xiaoyuehai/heichips26-e2spike/macros/heichips26_e2spike/macros/counter/netlist/spice/counter.spice

* NGSPICE file created from counter.ext - technology: ihp-sg13cmos5l

* Black-box entry subcircuit for sg13cmos5l_decap_8 abstract view
.subckt sg13cmos5l_decap_8 VDD VSS
.ends

* Black-box entry subcircuit for sg13cmos5l_decap_4 abstract view
.subckt sg13cmos5l_decap_4 VDD VSS
.ends

* Black-box entry subcircuit for sg13cmos5l_nor3_2 abstract view
.subckt sg13cmos5l_nor3_2 Y A B C VDD VSS
.ends

* Black-box entry subcircuit for sg13cmos5l_xor2_1 abstract view
.subckt sg13cmos5l_xor2_1 X A B VDD VSS
.ends

* Black-box entry subcircuit for sg13cmos5l_fill_2 abstract view
.subckt sg13cmos5l_fill_2 VDD VSS
.ends

* Black-box entry subcircuit for sg13cmos5l_dlygate4sd3_1 abstract view
.subckt sg13cmos5l_dlygate4sd3_1 X A VDD VSS
.ends

* Black-box entry subcircuit for sg13cmos5l_buf_1 abstract view
.subckt sg13cmos5l_buf_1 X A VDD VSS
.ends

* Black-box entry subcircuit for sg13cmos5l_tiehi abstract view
.subckt sg13cmos5l_tiehi L_HI VDD VSS
.ends

* Black-box entry subcircuit for sg13cmos5l_fill_1 abstract view
.subckt sg13cmos5l_fill_1 VDD VSS
.ends

* Black-box entry subcircuit for sg13cmos5l_inv_1 abstract view
.subckt sg13cmos5l_inv_1 Y A VDD VSS
.ends

* Black-box entry subcircuit for sg13cmos5l_nand4_1 abstract view
.subckt sg13cmos5l_nand4_1 Y A B C D VDD VSS
.ends

* Black-box entry subcircuit for sg13cmos5l_nor2b_1 abstract view
.subckt sg13cmos5l_nor2b_1 Y A B_N VDD VSS
.ends

* Black-box entry subcircuit for sg13cmos5l_nor2_1 abstract view
.subckt sg13cmos5l_nor2_1 Y A B VDD VSS
.ends

* Black-box entry subcircuit for sg13cmos5l_and2_1 abstract view
.subckt sg13cmos5l_and2_1 X A B VDD VSS
.ends

* Black-box entry subcircuit for sg13cmos5l_a21oi_1 abstract view
.subckt sg13cmos5l_a21oi_1 Y A1 A2 B1 VDD VSS
.ends

* Black-box entry subcircuit for sg13cmos5l_buf_4 abstract view
.subckt sg13cmos5l_buf_4 X A VDD VSS
.ends

* Black-box entry subcircuit for sg13cmos5l_or3_1 abstract view
.subckt sg13cmos5l_or3_1 X A B C VDD VSS
.ends

* Black-box entry subcircuit for sg13cmos5l_nand3_1 abstract view
.subckt sg13cmos5l_nand3_1 Y A B C VDD VSS
.ends

* Black-box entry subcircuit for sg13cmos5l_buf_8 abstract view
.subckt sg13cmos5l_buf_8 X A VDD VSS
.ends

* Black-box entry subcircuit for sg13cmos5l_o21ai_1 abstract view
.subckt sg13cmos5l_o21ai_1 Y A1 A2 B1 VDD VSS
.ends

* Black-box entry subcircuit for sg13cmos5l_nand2_1 abstract view
.subckt sg13cmos5l_nand2_1 Y A B VDD VSS
.ends

* Black-box entry subcircuit for sg13cmos5l_dfrbpq_1 abstract view
.subckt sg13cmos5l_dfrbpq_1 Q CLK D RESET_B VDD VSS
.ends

* Black-box entry subcircuit for sg13cmos5l_xnor2_1 abstract view
.subckt sg13cmos5l_xnor2_1 Y A B VDD VSS
.ends

* Black-box entry subcircuit for sg13cmos5l_mux2_1 abstract view
.subckt sg13cmos5l_mux2_1 X A0 A1 S VDD VSS
.ends

.subckt counter VGND VPWR clk_i count_o[0] count_o[1] count_o[2] count_o[3] count_o[4]
+ count_o[5] count_o[6] count_o[7] enable_i rst_ni
XFILLER_7_7 VPWR VGND sg13cmos5l_decap_8
XFILLER_3_67 VPWR VGND sg13cmos5l_decap_8
XFILLER_9_126 VPWR VGND sg13cmos5l_decap_8
XFILLER_13_144 VPWR VGND sg13cmos5l_decap_4
XFILLER_5_140 VPWR VGND sg13cmos5l_decap_8
X_66_ _67_/S _66_/A _66_/B _66_/C VPWR VGND sg13cmos5l_nor3_2
XFILLER_0_35 VPWR VGND sg13cmos5l_decap_8
XFILLER_9_77 VPWR VGND sg13cmos5l_decap_8
X_49_ _49_/X _59_/C _49_/B VPWR VGND sg13cmos5l_xor2_1
XFILLER_18_97 VPWR VGND sg13cmos5l_decap_8
XFILLER_18_42 VPWR VGND sg13cmos5l_fill_2
XFILLER_18_20 VPWR VGND sg13cmos5l_fill_2
Xhold30 _59_/C _71_/Q VPWR VGND sg13cmos5l_dlygate4sd3_1
XFILLER_6_56 VPWR VGND sg13cmos5l_decap_8
Xoutput7 count_o[4] _72_/Q VPWR VGND sg13cmos5l_buf_1
XFILLER_11_0 VPWR VGND sg13cmos5l_decap_8
X_75__14 _75__14/L_HI VPWR VGND sg13cmos5l_tiehi
XFILLER_3_46 VPWR VGND sg13cmos5l_decap_8
XFILLER_9_105 VPWR VGND sg13cmos5l_decap_8
XFILLER_9_149 VPWR VGND sg13cmos5l_fill_1
XFILLER_13_123 VPWR VGND sg13cmos5l_decap_8
XFILLER_6_119 VPWR VGND sg13cmos5l_decap_8
XFILLER_10_137 VPWR VGND sg13cmos5l_decap_8
XFILLER_10_148 VPWR VGND sg13cmos5l_fill_2
X_65_ _66_/A _65_/A VPWR VGND sg13cmos5l_inv_1
XFILLER_2_133 VPWR VGND sg13cmos5l_decap_8
XFILLER_0_14 VPWR VGND sg13cmos5l_decap_8
XFILLER_9_56 VPWR VGND sg13cmos5l_decap_8
X_48_ _49_/B _48_/A _70_/Q _48_/C _48_/D VPWR VGND sg13cmos5l_nand4_1
XFILLER_18_76 VPWR VGND sg13cmos5l_decap_4
XFILLER_15_7 VPWR VGND sg13cmos5l_fill_2
Xhold20 _58_/A1 _56_/Y VPWR VGND sg13cmos5l_dlygate4sd3_1
Xhold31 _50_/B _49_/X VPWR VGND sg13cmos5l_dlygate4sd3_1
XFILLER_6_35 VPWR VGND sg13cmos5l_decap_8
XFILLER_13_4 VPWR VGND sg13cmos5l_fill_1
XFILLER_15_66 VPWR VGND sg13cmos5l_decap_8
Xoutput10 count_o[7] _75_/Q VPWR VGND sg13cmos5l_buf_1
Xoutput8 count_o[5] _73_/Q VPWR VGND sg13cmos5l_buf_1
XFILLER_16_143 VPWR VGND sg13cmos5l_decap_8
XFILLER_3_25 VPWR VGND sg13cmos5l_decap_8
XFILLER_10_116 VPWR VGND sg13cmos5l_decap_8
XFILLER_12_67 VPWR VGND sg13cmos5l_fill_2
X_64_ _64_/Y _64_/A _63_/B VPWR VGND sg13cmos5l_nor2b_1
XFILLER_2_112 VPWR VGND sg13cmos5l_decap_8
XFILLER_9_35 VPWR VGND sg13cmos5l_decap_8
X_47_ _70_/D _50_/A _47_/B VPWR VGND sg13cmos5l_nor2_1
XFILLER_18_33 VPWR VGND sg13cmos5l_fill_1
XFILLER_1_0 VPWR VGND sg13cmos5l_decap_8
XFILLER_1_91 VPWR VGND sg13cmos5l_decap_8
Xhold21 _73_/D _58_/Y VPWR VGND sg13cmos5l_dlygate4sd3_1
XFILLER_6_14 VPWR VGND sg13cmos5l_decap_8
Xhold32 _64_/A _75_/Q VPWR VGND sg13cmos5l_dlygate4sd3_1
Xoutput9 count_o[6] _74_/Q VPWR VGND sg13cmos5l_buf_1
XFILLER_16_122 VPWR VGND sg13cmos5l_decap_8
XFILLER_15_56 VPWR VGND sg13cmos5l_fill_1
XFILLER_13_103 VPWR VGND sg13cmos5l_fill_1
XFILLER_8_140 VPWR VGND sg13cmos5l_decap_8
XFILLER_5_7 VPWR VGND sg13cmos5l_decap_8
XFILLER_12_24 VPWR VGND sg13cmos5l_decap_8
XFILLER_12_35 VPWR VGND sg13cmos5l_fill_1
XFILLER_4_91 VPWR VGND sg13cmos5l_decap_8
X_63_ _63_/X _64_/A _63_/B VPWR VGND sg13cmos5l_and2_1
XFILLER_3_4 VPWR VGND sg13cmos5l_decap_8
XFILLER_0_49 VPWR VGND sg13cmos5l_decap_8
XFILLER_9_14 VPWR VGND sg13cmos5l_decap_8
X_46_ _47_/B _46_/A _66_/B VPWR VGND sg13cmos5l_xor2_1
XFILLER_1_70 VPWR VGND sg13cmos5l_decap_8
Xhold22 _65_/A _74_/Q VPWR VGND sg13cmos5l_dlygate4sd3_1
Xhold33 _75_/D _67_/X VPWR VGND sg13cmos5l_dlygate4sd3_1
XFILLER_7_91 VPWR VGND sg13cmos5l_decap_8
XFILLER_9_119 VPWR VGND sg13cmos5l_decap_8
XFILLER_13_137 VPWR VGND sg13cmos5l_decap_8
XFILLER_13_148 VPWR VGND sg13cmos5l_fill_2
XFILLER_5_133 VPWR VGND sg13cmos5l_decap_8
X_62_ _62_/Y _62_/A1 _61_/X _50_/A VPWR VGND sg13cmos5l_a21oi_1
XFILLER_2_147 VPWR VGND sg13cmos5l_fill_2
XFILLER_4_70 VPWR VGND sg13cmos5l_decap_8
XFILLER_0_28 VPWR VGND sg13cmos5l_decap_8
X_45_ _66_/B _45_/A VPWR VGND sg13cmos5l_buf_4
Xhold23 _62_/A1 _60_/Y VPWR VGND sg13cmos5l_dlygate4sd3_1
Xhold34 _46_/A _70_/Q VPWR VGND sg13cmos5l_dlygate4sd3_1
XFILLER_6_49 VPWR VGND sg13cmos5l_decap_8
XFILLER_7_70 VPWR VGND sg13cmos5l_decap_8
XFILLER_3_39 VPWR VGND sg13cmos5l_decap_8
X_61_ _61_/X _65_/A _66_/B _66_/C VPWR VGND sg13cmos5l_or3_1
XFILLER_5_112 VPWR VGND sg13cmos5l_decap_8
XFILLER_2_126 VPWR VGND sg13cmos5l_decap_8
XFILLER_9_49 VPWR VGND sg13cmos5l_decap_8
X_44_ _45_/A _48_/A _48_/C _48_/D VPWR VGND sg13cmos5l_nand3_1
XFILLER_18_69 VPWR VGND sg13cmos5l_decap_8
Xhold24 _74_/D _62_/Y VPWR VGND sg13cmos5l_dlygate4sd3_1
XFILLER_6_28 VPWR VGND sg13cmos5l_decap_8
XFILLER_10_81 VPWR VGND sg13cmos5l_decap_8
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
XFILLER_9_21 VPWR VGND sg13cmos5l_decap_8
XFILLER_9_98 VPWR VGND sg13cmos5l_decap_8
XFILLER_18_63 VPWR VGND sg13cmos5l_fill_2
XFILLER_18_52 VPWR VGND sg13cmos5l_decap_8
XFILLER_6_77 VPWR VGND sg13cmos5l_decap_8
Xoutput6 count_o[3] _71_/Q VPWR VGND sg13cmos5l_buf_1
.ends
