xiaoyuehai/heichips26-e2spike/macros/heichips26_e2spike/rtl/d_ff.v

module d_ff #(
    parameter integer w_WIDTH = 8
) (
    input  wire               clk,
    input  wire               rst,
    input  wire               learn_en,
    input  wire [w_WIDTH-1:0] d,
    output reg  [w_WIDTH-1:0] q
);

    always @(posedge clk or posedge rst) begin
        if (rst)
            q <= {w_WIDTH{1'b0}};
        else if(learn_en)
            q <= d;
    end

endmodule
