xiaoyuehai/heichips26-e2spike/(commit log)

2026-08-07 updated files
    [counter_tb_tran.sch, heichips26_analog_project.sch, heichips26_analog_project_tb_tran.csv, heichips26_analog_project_tb_tran.sch, inverter.sch, inverter_tb_ac.csv, inverter_tb_ac.sch, inverter_tb_ac_ol.csv]
2026-08-07 add Ca reset mechanism for each sample
2026-09-15 Fix the fc1/fc2 scale-bias overlap at word 232 in the memory image
    The layer table in interface/bank_cfg.pat still carries the pre-hackathon
    addresses: fc1 reads scale, bias (ch 0-3) and bias (ch 4-7) from words
    230..232, and fc2 reads its block from 232..234. Word 232 holds fc2's scale
    bytes (0x8383) and fc1 reads it as the bias of its output channels 4-7, so
    channel 4 gets a bias of -31869 and never fires.
    Move fc2's scale/bias block to word 494. Words 494 and 495 are not read or
    written by any other layer (SRAM access trace of a full inference), and fc2
    only uses output neurons 0 and 1, so its channel 4-7 bias word landing on the
    first depthwise membrane word is harmless. Three physical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
2026-09-15 Add a self-checking testbench at the macro pins for RTL and final/nl
    The testbenches that came with the template still exercised
    heichips26_digital_project and its counter, so make sim-rtl-verilog and the
    cocotb targets could not run for this macro. Replace them with a testbench
    for heichips26_e2spike.
    heichips26_e2spike_tb.v puts around the macro what the HeiChips chip puts
    there: a memory controller for the IHP 1024x32 SRAM (efpga_mem_ctrl.v, the
    logic of rtl/fpga_emu/mem_ctrl.v on the SRAM's pins) and the SRAM model from
    the PDK. Nothing inside the DUT is forced. The default run loads
    interface/bank_cfg.pat, runs one inference and checks:
    * the SRAM after ds1, ds2, ds3, fc1 and at the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
    [efpga_mem_ctrl.v, gl_udp_init.py, heichips26_e2spike_tb.v]
2026-09-15 Add signoff reports of the committed views
    verification/ was empty in the repository. Add reports of checks run on
    exactly what submission.yaml points at, final/ as of 97c14ec, without
    re-hardening:
    * organisers' precheck with three IHP-Open-PDK checkouts (the one this
    repository pins, the tapeout repository's, the template's newest):
    0 zero-area polygons, 0 antenna, 0 Magic DRC, 0 KLayout DRC each
    * LVS from the GDS with Magic and Netgen (10249 devices, 10244 nets) and
    with IHP's KLayout runset (match, strict ports)
    * STA in three corners at 10 ns: hold met everywhere, setup met in typ
    and fast, -2.21 ns in slow (82 MHz); the chip top uses 15 ns
    verification/README.m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
    [precheck_metrics.csv]
